brettski74/Modular-Solder-Reflow/README.md

# Modular-Solder-Reflow
Modular designs for a DIY solder reflow hotplate, controller, power supply and more.
