brettski74/Modular-Solder-Reflow/Hardware/PowerSection/spice/PowerSection.asc

B1: bv; V=200*(V(v-)-V(vd))+(V(v-)+V(Vd))*0.00023
B2: bv; V=20*(V(v-)-V(vd))+(V(v-)+V(Vd))*0.002+0.005
B3: bv; V=max(0,min(V(vin),V(rawlo)))
B4: bv; V=max(0,min(V(vin),V(rawhi)))
C1: cap; 100µ; V=50 Rser=0
C3: cap; 100n
C4: cap; 100n
C7: cap; 1n; V=100 Rser=10m
C8: cap; 1n; V=100 Rser=10m
C9: cap; 100µ; V=50 Rser=0
D1: schottky; ZLLS2000
D2: schottky; B540C
F1: res; 0.0039
L1: ind; 2.2µ; Ipk=15 Rser=.005
L2: ind; 22µ; Ipk=8 Rser=33m
Q1: nmos; 2N7002
Q2: nmos; BUK960940B
R1: res; 1000
R2: res; 1000
R3: res; 10
R4: res; 10k
R5: res; 1k
R6: res; 100
R7: res; 10
R8: res; 100
R9: res; 10k
R10: res; 100
R11: res; 0.015
Ramp1: res; 1000k
Ramp2: res; 1000k
Rc1: res; 35m
Rc9: res; 35m
Rhtr: res; 1.2
U4a: npn; 2N2222
U4b: pnp; BCW68F
V1: voltage; PULSE(3.3 0 0 100n 100n 9.9u 15.8u 3700); Rser=8
V2: voltage; 19; Rser=0.1
V3: voltage; 3.3; Rser=0.1
Named nets: 0, V+, V-, Vs, Vpulse, Ilo, Vgate, Vsh, Vdrv, Vd, Ihi, Vin, rawlo, rawhi, Vesr, Vbuf, Vl
.tran 10m startup
