brettski74/Modular-Solder-Reflow/Hardware/PowerSection/PowerSection.kicad_pcb

## KiCad design Hardware/PowerSection/PowerSection.kicad_pcb (2023-04-29)

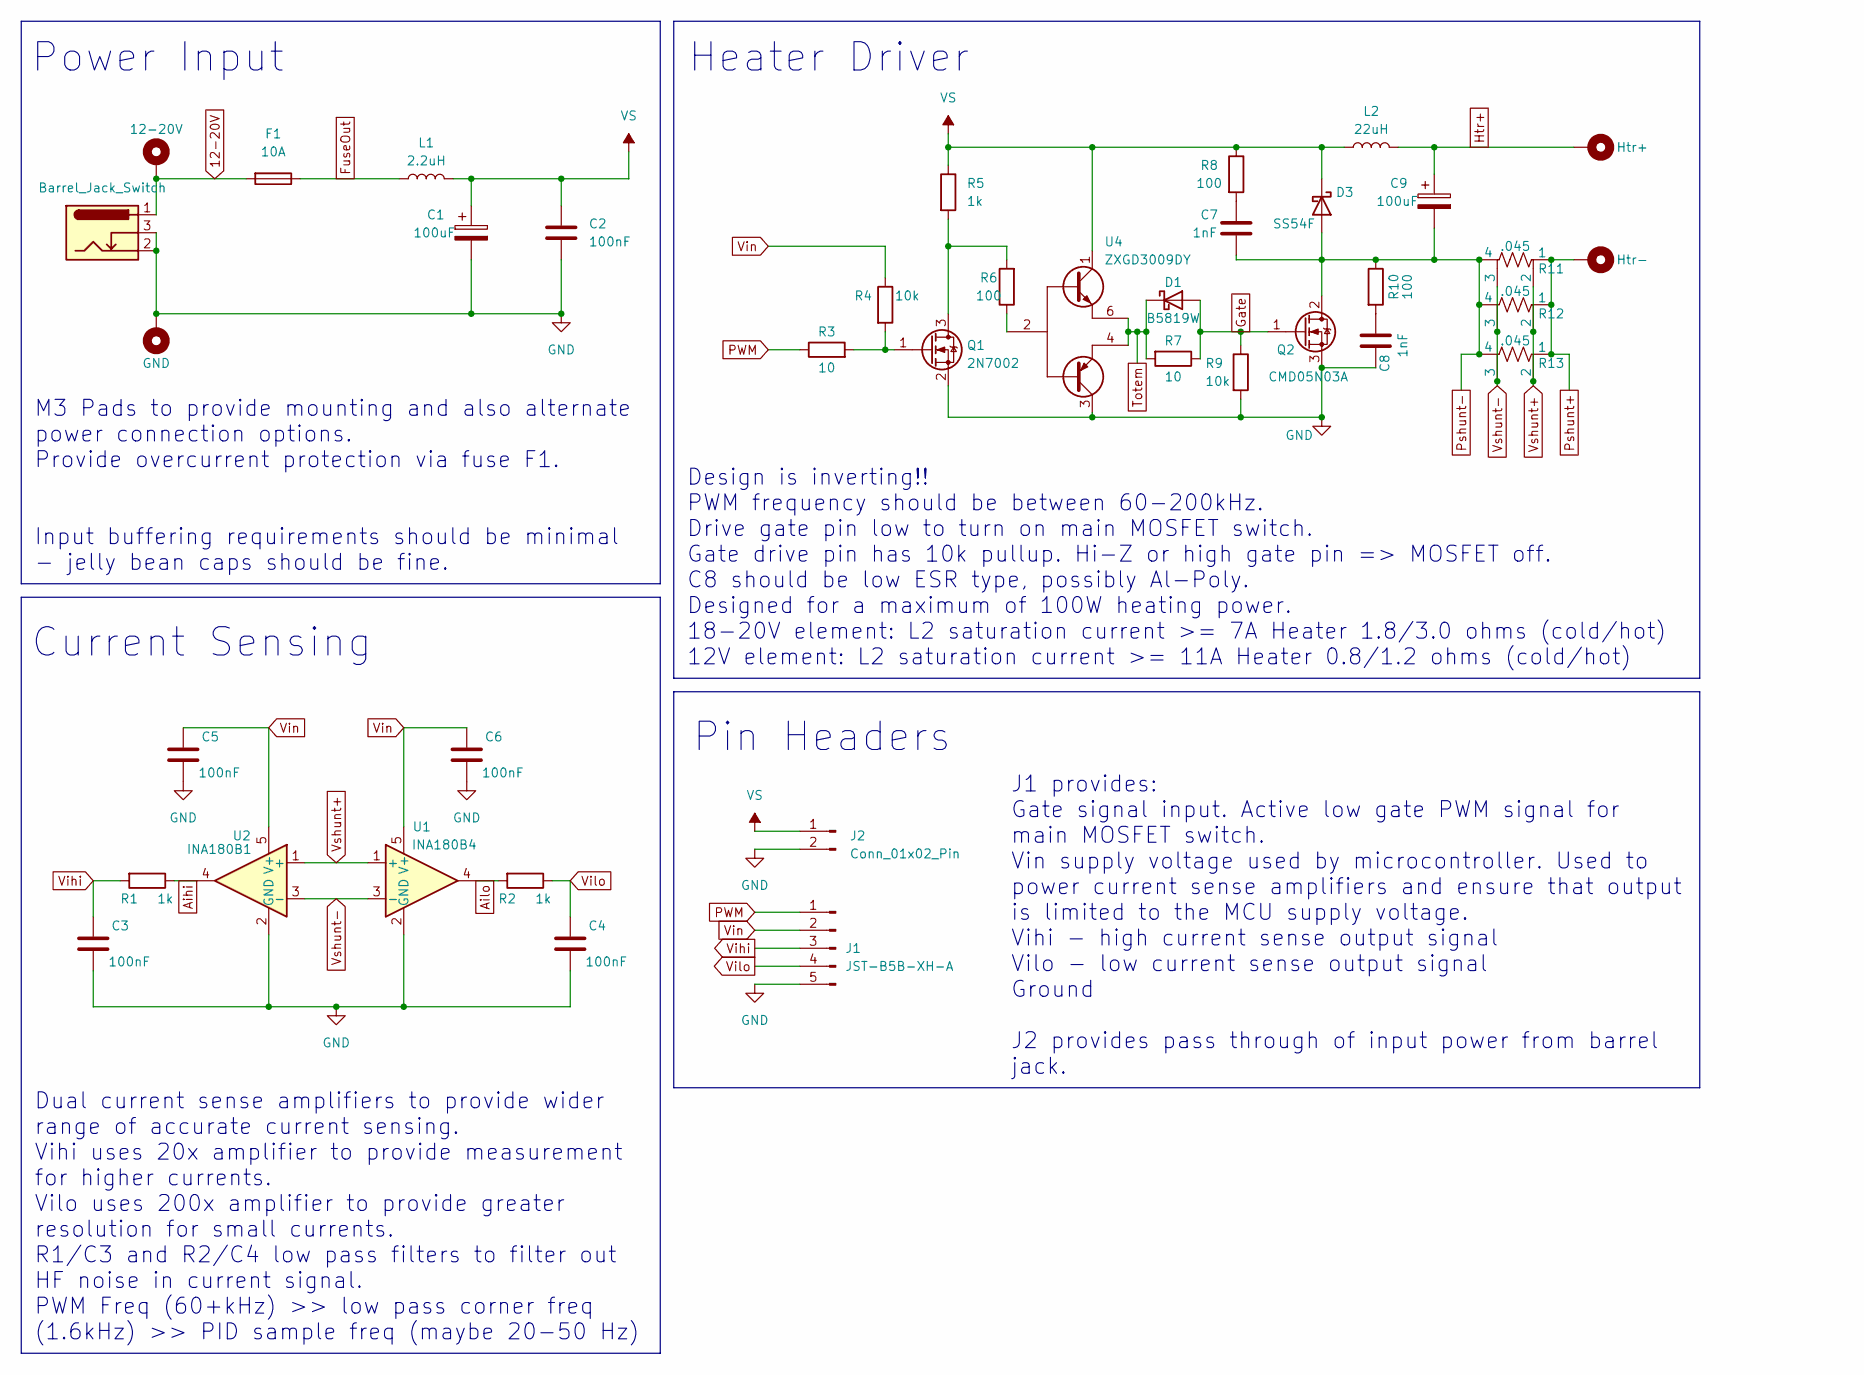
[picture p2: schematic PowerSection.kicad_sch, Modular Solder Reflow Power Section]

Parts:
12V1: Barrel_Jack_Switch; BarrelJack_GCT_DCJ200-10-A_Horizontal; LCSC Part C5155560
C1, C9: 100uF; CP_Elec_8x10.5; LCSC Part C454651
C2, C3, C4, C5, C6: 100nF; C_0603_1608Metric
C7: 1nF; R_0603_1608Metric
C8: 1nF; C_0603_1608Metric
D1: B5819W; D_SOD-123; LCSC Part C2943878
D3: SS54F; D_SMBF; LCSC Part C2922187
F1: 10A; R_1206_Fuse; LCSC Part C207003
H1, H2: MountingHole_Pad; MountingHole_3.2mm_M3_Pad_Via
H3, H4: Heater Pad; MountingHole_3.2mm_M3_Pad_Via
J1: JST-B5B-XH-A; JST_XH_B5B-XH-A_1x05_P2.50mm_Vertical; LCSC Part C722877
J2: Conn_01x02_Pin; PinHeader_1x02_P2.54mm_Vertical; LCSC Part C2894925
L1: 2.2uH; L_12x12-ish; LCSC Part C2921227
L2: 22uH; L_25x15_FlatWire; LCSC Part C2761965
Q1: 2N7002; SOT-23; LCSC Part C2898356
Q2: CMD05N03A; TO-252-2; LCSC Part C5203816
R1, R2, R5: 1k; R_0603_1608Metric
R3, R7: 10; R_0603_1608Metric
R4, R9: 10k; R_0603_1608Metric
R6, R8, R10: 100; R_0603_1608Metric
R11, R12, R13: .045; R_2512_Kelvin_Shunt; LCSC Part C2683379
U1: INA180B4; SOT-23-5; LCSC Part C1879708
U2: INA180B1; SOT-23-5; LCSC Part C544664
U4: ZXGD3009DY; SOT-363_SC-70-6; LCSC Part C441818

Connections:
12-20V: 12V1.1, F1.2, H1.1
Aihi: R1.1, U2.4
Ailo: R2.2, U1.4
FuseOut: F1.1, L1.1
GND: 12V1.2, 12V1.3, C1.2, C2.2, C3.2, C4.2, C5.2, C6.2, C8.2, H2.1, J1.5, J2.2, Q1.2 (S), Q2.3 (S), R9.2, U1.2 (GND), U2.2 (GND), U4.3 (Vee)
Gate: D1.2 (A), Q2.1 (G), R7.1, R9.1
Htr+: C9.1, H3.1, L2.2
unnamed: C7.1, R8.2
unnamed: C8.1, R10.2
unnamed: Q1.3 (D), R5.2, R6.2
unnamed: Q1.1 (G), R3.2, R4.2
unnamed: R6.1, U4.2 (B)
PWM: J1.1, R3.1
Pshunt+: H4.1, R11.1, R12.1, R13.1
Pshunt-: C7.2, C9.2, D3.2 (A), Q2.2 (D), R10.1, R11.4, R12.4, R13.4
Totem: D1.1 (K), R7.2, U4.4 (Sink), U4.6 (Source)
VS: C1.1, C2.1, D3.1 (K), J2.1, L1.2, L2.1, R5.1, R8.1, U4.1 (Vcc)
Vihi: C3.1, J1.3, R1.2
Vilo: C4.1, J1.4, R2.1
Vin: C5.1, C6.1, J1.2, R4.1, U1.5 (V+), U2.5 (V+)
Vshunt+: R11.2, R12.2, R13.2, U1.1 (+), U2.1 (+)
Vshunt-: R11.3, R12.3, R13.3, U1.3 (-), U2.3 (-)

Notes on the sheet:
Design is inverting!! PWM frequency should be between 60-200kHz. Drive gate pin low to turn on main MOSFET switch. Gate drive pin has 10k pullup. Hi-Z or high gate pin => MOSFET off. C8 should be low ESR type, possibly Al-Poly. Designed for a maximum of 100W heating power. 18-20V element: L2 satura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
Dual current sense amplifiers to provide wider range of accurate current sensing. Vihi uses 20x amplifier to provide measurement for higher currents. Vilo uses 200x amplifier to provide greater resolution for small currents. R1/C3 and R2/C4 low pass filters to filter out HF noise in current signal.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
M3 Pads to provide mounting and also alternate power connection options. Provide overcurrent protection via fuse F1. Input buffering requirements should be minimal - jelly bean caps should be fine.
J1 provides: Gate signal input. Active low gate PWM signal for main MOSFET switch. Vin supply voltage used by microcontroller. Used to power current sense amplifiers and ensure that output is limited to the MCU supply voltage. Vihi - high current sense output signal Vilo - low current sense output 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
Power Input
Pin Headers
Heater Driver
Current Sensing

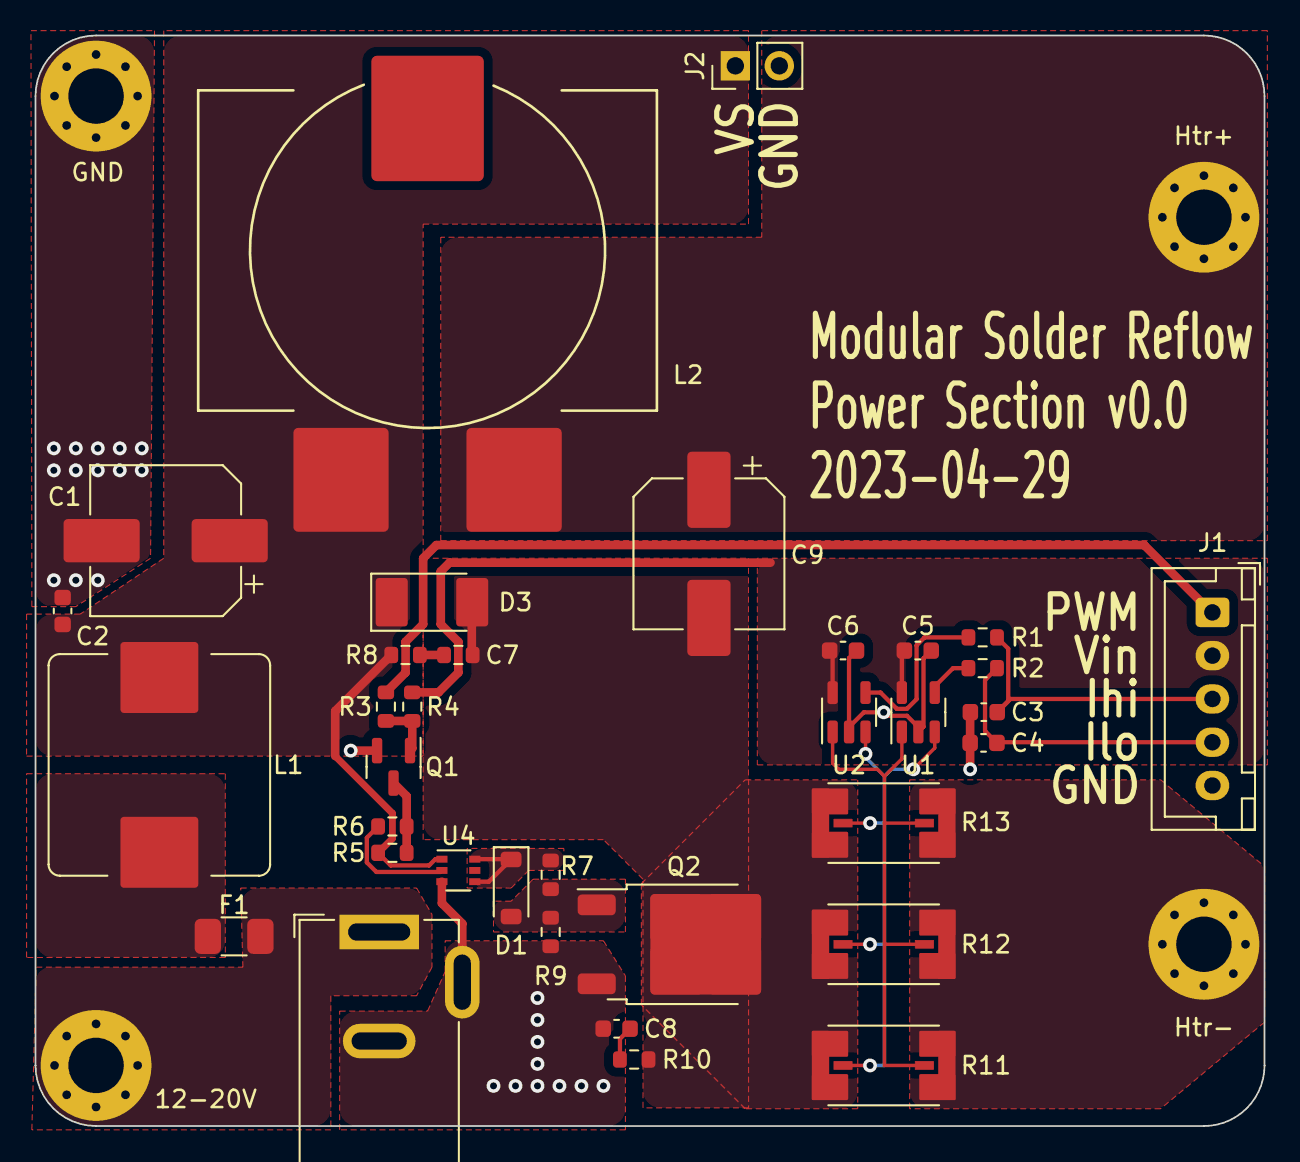
[picture p3: board PowerSection.kicad_pcb from above]

Board: 2 copper layers, 71.0 x 63.0 mm, 39 parts (0 on the bottom side), 22 nets.
