brettski74/Modular-Solder-Reflow/(commit log)

2023-04-26 Initial commit of power section schematic and LTSpice model.
    [PowerSection.kicad_pcb, PowerSection.kicad_sch]
2023-04-26 Annotated some parts with LCSC and Digikey part numbers. Updated spice model to match reference designators in the Kicad schematic.
    [PowerSection.kicad_sch]
2023-04-27 Replaced custom global symbols with standard KiCad symbols or local project symbols.
    [PowerSection.kicad_sch]
2023-04-28 Updated footprints to use standard or project local footprints. Updated component specs to handle 12V 100W hotplates - beefier inductors. Added input ripple filter inductor.
    [PowerSection.kicad_sch]
2023-04-28 Fixed inductor reference designators on PowerSection design.
    [PowerSection.kicad_sch]
2023-04-29 Initial rough layout completed, with minor schematic changes to address layout challenges.
    [PowerSection.kicad_pcb, PowerSection.kicad_sch]
2023-04-29 Minor tweaks - labeling contacts and such.
    [PowerSection.kicad_pcb]
2023-04-29 Fixed design rule checker violations and unconnected fill zone for Vin on U1.
    [PowerSection.kicad_pcb]
2023-04-29 Plotted Power Section PCB v0.0 for JLCPCB fabrication.
    [PowerSection-B_Cu.gbl, PowerSection-B_Mask.gbs, PowerSection-B_Paste.gbp, PowerSection-B_Silkscreen.gbo, PowerSection-Edge_Cuts.gm1, PowerSection-F_Cu.gtl, PowerSection-F_Mask.gts, PowerSection-F_Paste.gtp]
2023-04-29 Added missing vias for ground fills. Added specifications text on the back of the board.
    [PowerSection-B_Cu.gbl, PowerSection-B_Mask.gbs, PowerSection-B_Paste.gbp, PowerSection-B_Silkscreen.gbo, PowerSection-Edge_Cuts.gm1, PowerSection-F_Cu.gtl, PowerSection-F_Mask.gts, PowerSection-F_Paste.gtp]
2023-04-29 Initial pass at readme file for Power Section Design Updated 3d models for the inductors and barrel jack.
    [PowerSection.kicad_pcb]
2023-04-30 Added more usage information for the power module in README.md.
2023-04-30 Fixed italics in README.md for Hardware/PowerSection.
2023-04-30 Fixed milliohm unit symbols in Hardware/PowerSection/README.md.
2023-05-01 Fixed a couple of typos in the Hardware/PowerSection/README.
2023-05-03 Added connection diagram to PowerSection README
